Staudi14/RF_Id/Docu images/photo_2019-05-31_14-45-52.jpg

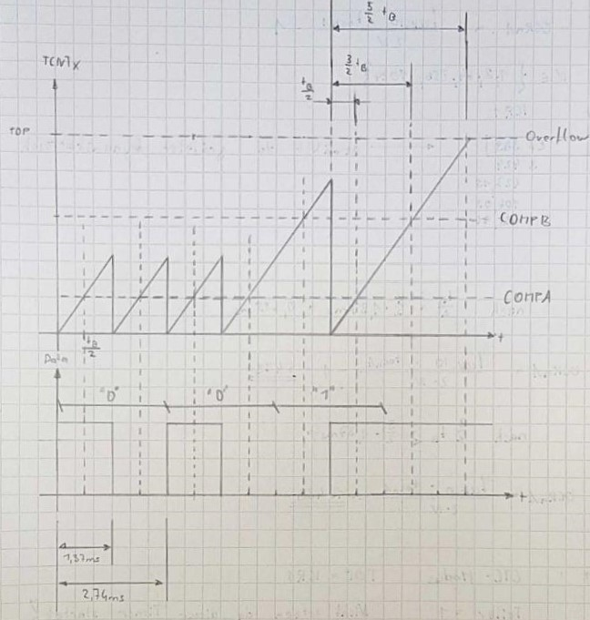
Docu images/photo_2019-05-31_14-45-52.jpg
