Staudi14/RF_Id/Dokumentation RF_ID.docx

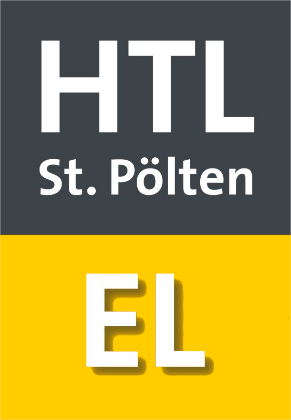
[picture p2: figure]

Dokumentation für RF-ID
Klasse | Teammitglied | Signature
4AHELS | Patrik Staudenmayer
Abgabedatum | Teammitglied | Signature
07.06.2019 | Marie Maier
Lehrer | Teammitglied | Signature
Tillich, Gruber, Crha | -
Note | Teammitglied | Signature

Projektbeschreibung

Aufbau und Programmierung eines RF-ID Tags und Lesegerät

USED DEVICES

Nummer | Gerät | Firma | Typ
1 | Labornetzteil
2 | Oszilloskope

Cover Sheet E2014 v3

Inhaltsverzeichniss

# 1 Hardware

## Lesegerät

### 1.1.1 Schaltung

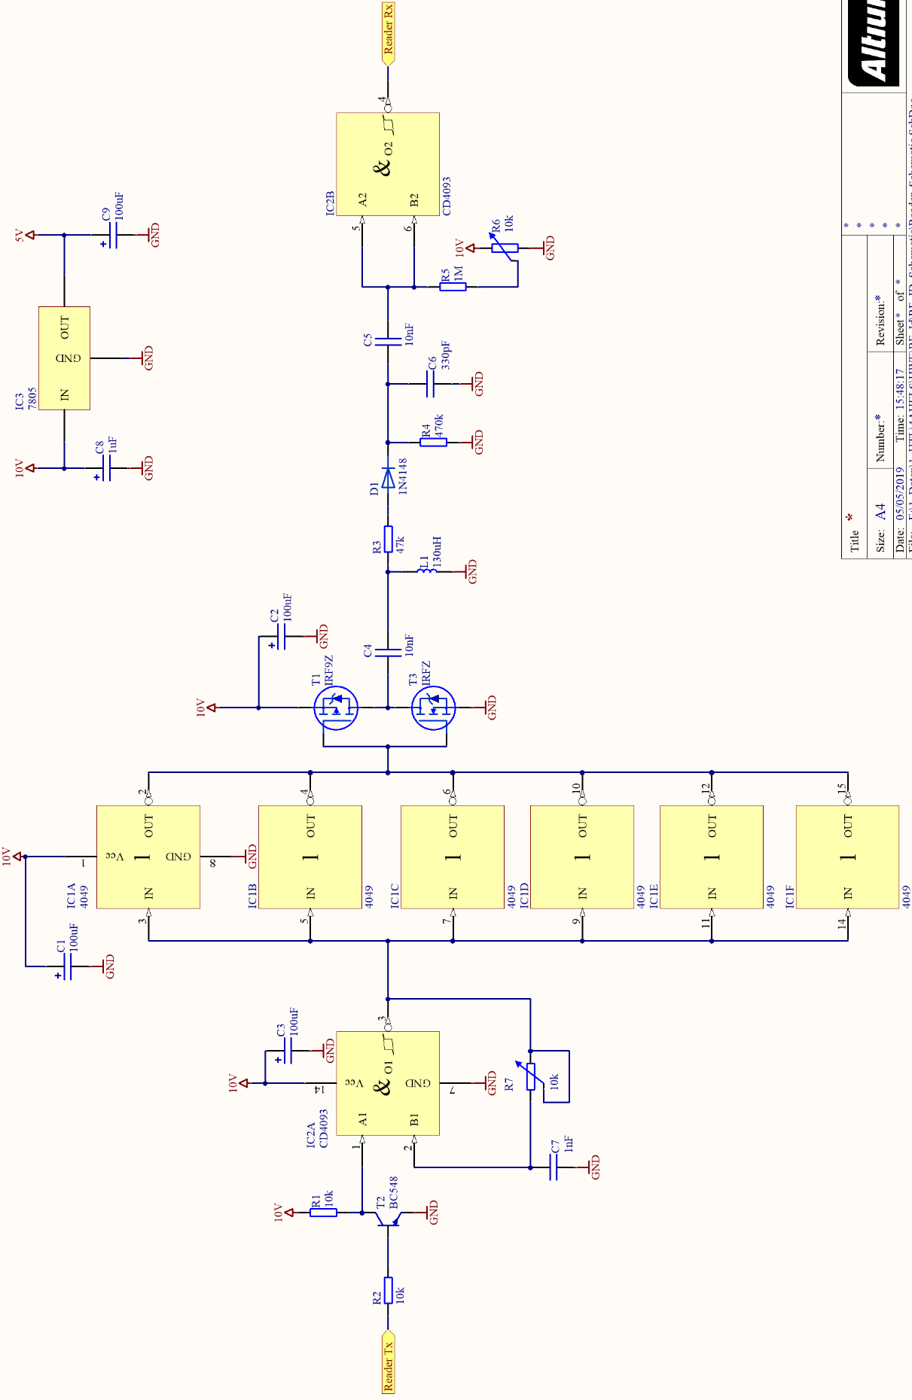
[picture p3: figure]

Endstufe

Treiber

Demodulator

Schwingkreis (≈100kHz)

RC-Oszillator ( ≈100kHz )

Abbildung 1: Schaltung Lesegerät

Abbildung 2: Schaltung Lesegerät Daten einlesen

Zum einlesen der Daten wird ein 8 Bit Schieberegister verwendet. Nachdem nur 7 Bits benötigt werden wurden nur sieben der acht Parallelen Ausgänge, des Schieberegister IC5 verwendet.

### 1.1.3 Berechnungen

#### 1.1.3.1 Resonanzfrequenz RC-Oszillator

f_0 ≈100kHz

C7=1nF

f_o ≈(2,5)/(R7*C7)

⇒R7=(2,5)/(C7* f_o)=(2,5)/(1nF*100kHz)=25kΩ

Durch Testen wurde festgestellt das ein 10k Potentiometer ausreicht, zum einstellen der gewünschten Resonanzfrequenz.

#### 1.1.3.2 Resonanzfrequenz Schwingkreis

L1=130μH

f_0 ≈100kHz

f_0 =1/(2*π*√(L1*C4))

⇒C4=((1/(f_0 *2*π))^2)/(L1)=((1/(100kHz*2*π))^2)/(130μF)=19nF

Ein 10nF Kondensator wurde verwendet, da die Oszillatorfrequenz mit dem Potentiometer abgeglichen werden kann.

## Tag

### 1.1.4 Schaltung

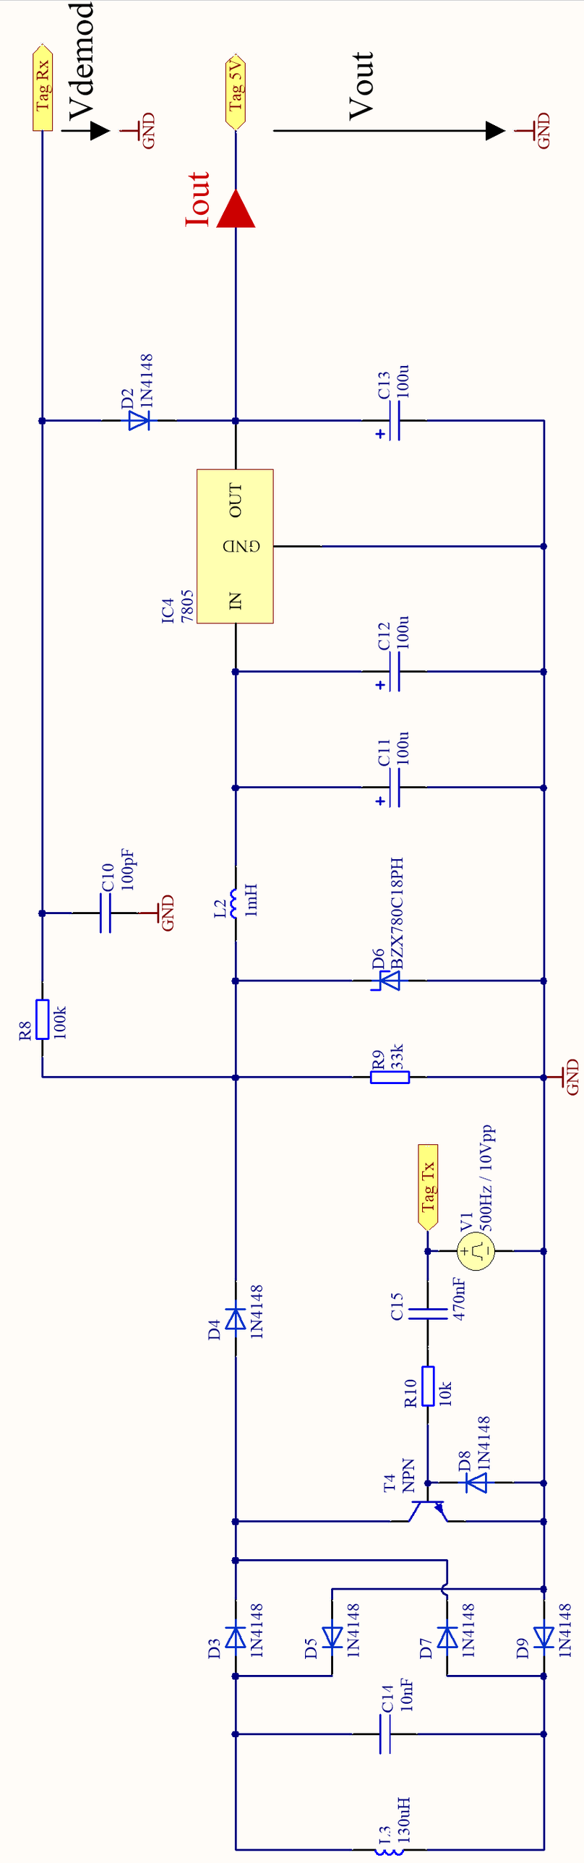
[picture p4: figure]

Längsregler 5V

Spannungsbegrenzung

Lastmodulator

Gleichrichter

Schwingkreis (≈100kHz)

Abbildung 3: Schaltung Tag

### 1.1.5 Berechnungen

#### 1.1.5.1 Schwingkreis

L3=130μH

f_0 ≈100kHz

f_0 =1/(2*π*√(L1*C4))

⇒C14=((1/(f_0 *2*π))^2)/(L1)=((1/(100kHz*2*π))^2)/(130μF)=19nF

Ein 10nF Kondensator wurde verwendet, da die Oszillatorfrequenz mit dem Potentiometer am Lesegerät abgeglichen werden kann.

### 1.1.6 Messungen

#### 1.1.6.1 Übertragungsfunktion der Spannungsversorgung des Tags

##### 1.1.6.1.1 Messschaltung

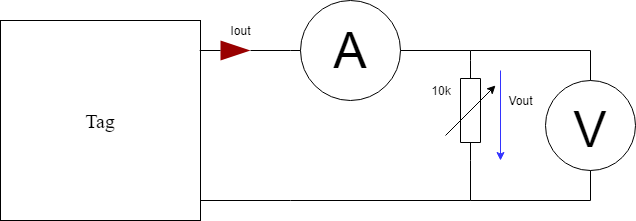
[picture p5: figure]

Abbildung 4: Messchaltung für Übertragungsfunktion Spannungsversorgung des Tags

Durch Variierung des 10kΩ Widerstands wurde die Last simuliert.

Abbildung 5: Messanordnung der Spulen

Spule Lesegerät

Plastik Abstandhalter

Spule Tag

5mm

##### 1.1.6.1.2 Messung

Vou | Iout
5.60 V | 0.04 mA
5.60 V | 6.63 mA
5.60 V | 13.74 mA
5.00 V | 18.74 mA
4.60 V | 20.67 mA
2.60 V | 23.24 mA
0.60 V | 26.11 mA

Abbildung 6: Messtabelle Übertragungsfunktion Spannungsversorgung des Tags

ssDer ATmega32u4 benötigt 14mA bei einer Taktfrequenz von 16MHz und einer Versorgungsspannung von 5V. Dies kann gerade so abgedeckt werden.

Abbildung 7: Diagramm Übertragungsfunktion Spannungsversorgung des Tags

## Übertragung zwischen Lesegerät und Tag

### 1.1.7 Übertragung von Tag zu Reader

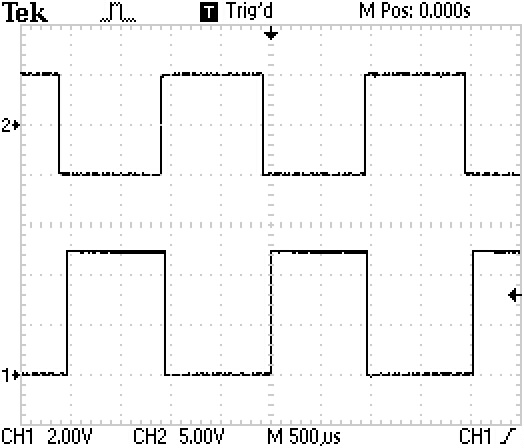
[picture p6: figure]

Tag RX

Tag TX

Abbildung 8: Oszillogramm Übertragung von Tag zu Reader

### 1.1.8 Übertragung von Reader zu Tag

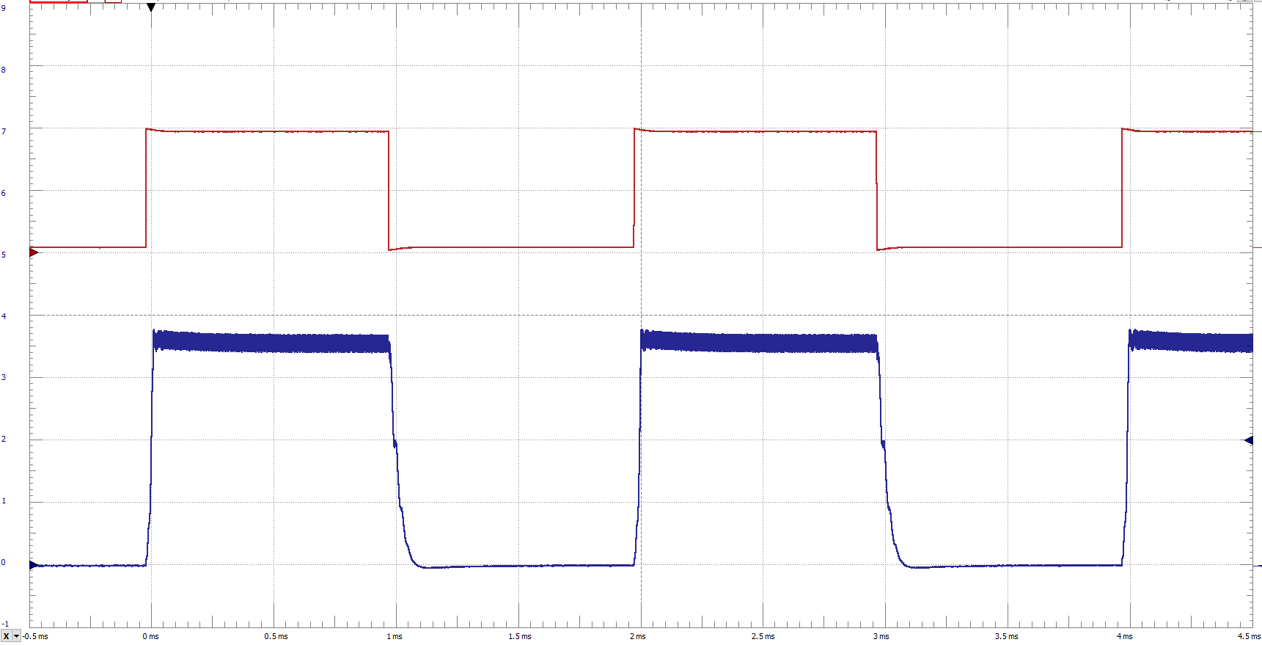
[picture p7: figure]

Tag Rx

1V/division

Reader Tx

2V/division

Abbildung 9: Oszillogramm Übertragung von Reader zu Tag

# 2 Software

Das verwendete Microcontrollerboard ist der „Flipp“ der HTBLuVA St.Pölten Abteilung für Elektronik und technische Informatik, welcher den ATmega32u4 Microcontroller beherbergt.

## Aufgabenstellung

Es soll eine Datenübertragung zwischen zwei Geräten mit folgenden Eigenschaften stattfinden:

- Zum Einlesen der Daten auf einer Seite soll ein SIPO (Seriell In, Parallel Out) Schieberegister verwendet werden.
- Die Daten sollen MSB First gespeichert werden.
- Zum Senden sollen die Daten geschoben werden.
- Die Bitdauer t_(Bit) soll 1,37ms betragen.
- Es soll das MSB zuerst gesendet werden.
- Zur Synchronisierung sollen zwei Startbits gesendet werden.
- Zur Datensicherung soll der Hamming Code verwendet werden.

Hamming (11/4) … insgesamt 11 Bit und davon 4 Paritätsbits

- Als Leitungscode soll die Manchesterkodierung verwendet werden

## Initialisierung

// RX instantiation

char GsaveD[RX_DATA_LENGTH + 1] = {0};

int8_t Gcounter = -4;

// TX instantiation

char GsendData[TX_DATA_LENGTH] = {0};

int8_t GsendCounter = 0;

char RXflag = FALSE;

void RfIDinit()

{

// Initialize Receiver Port

RX_PORT_DDR &= ~RX_PIN_MASK;

// Initial Transmitter Port

TX_PORT_DDR |= TX_PIN_MASK;

TX_PORT |= TX_PIN_MASK; // Set Tx to high to deliver energy

// Initialize Input port for shift register

DATA_INPUT_PORT_DDR = 0x00;

// Initialize Pin change interrupt

DDRD &= ~(1 << DDD3); // Initialize PD3 as Input

EICRA |= (1<<ISC31) | (1<<ISC30); // Trigger interrupt on rising and

falling edge

EIMSK |= (1<<INT3); // Locally enable Interrupt for INT3

// Initialize Timer1 for receiving

TCCR1B = TCCR1B | (1<<WGM13) | (1<<WGM12); // Set Timer1 to CTC-Mode with ICR1

as TOP

ICR1 = fICR; // Set TOP Value

OCR1A = fOCR1A; // Set threshold for COMP_A

OCR1B = fOCR1B; // Set threshold for COMP_B

TIMSK0 = TIMSK0 | (1<<OCIE0B) | (1<<OCIE0A) | (1<<ICIE1); //COMP_A, COMP_B and

Input capture as overflow

// Initialize Timer3 for sending

TCCR3B = TCCR3B | (1<<WGM33) | (1<<WGM32); // Set Timer1 to CTC-Mode with ICR3

as TOP

ICR3 = TOP_TX; // Set TOP Value

TIMSK3 |= (1 << ICIE3); // Enable Interrupt on ICIE3

}

## Manchester Kodierung

Aus zeitlichen Gründen wurde keine Manchester Kodierung programmiert.

Funktion der Manchester Kodierung:

Wenn Daten Manchester kodiert gesendet werden, werden aus einem Datenbit 2 Datenbits, aus einer 0 wird 10 und aus einer 1 wird 01. Weiters wird der Taktgehalt in der Übertragung erhöht, wodurch eine leichtere Synchronisierung von Sender und Empfänger möglich ist.

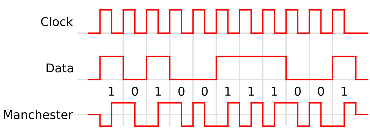
[picture p8: figure]
Bildergebnis fÃ¼r manchester codierung

Abbildung 10: Manchester Kodierung

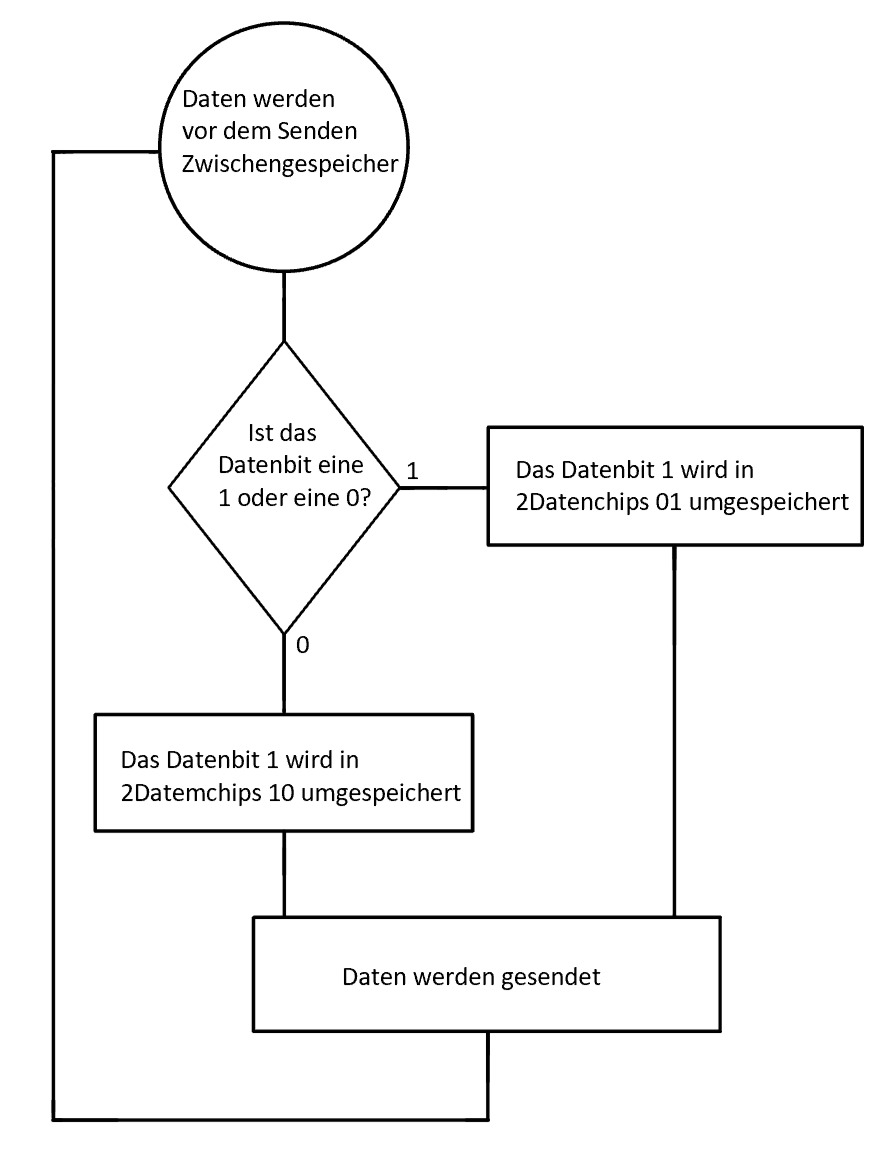
[picture p9: figure]

Abbildung 11: Flussdiagramm der Manchester Kodierung

## Hamming Code

Aus zeitlichen Gründen konnte die Hamming Codierung nicht mehr implementiert werden.

Der Hamming Code ist ein relativer Einfacher Code mit dem Hamming Abstand 3. Dies bedeutet das zwei Fehler erkannt werden können und ein Fehler korrigiert werden kann.

## Einlesen und Speichern der Daten

Aus zeitlichem Mangel konnte das Einlesen und Speichern der Daten nicht rechtzeitig fertig programmiert werden, daher wurde ein Flussdiagramm erstellt, um einen Überblick über den Ablauf der Einlese und Speicher Routine zu geben.

false

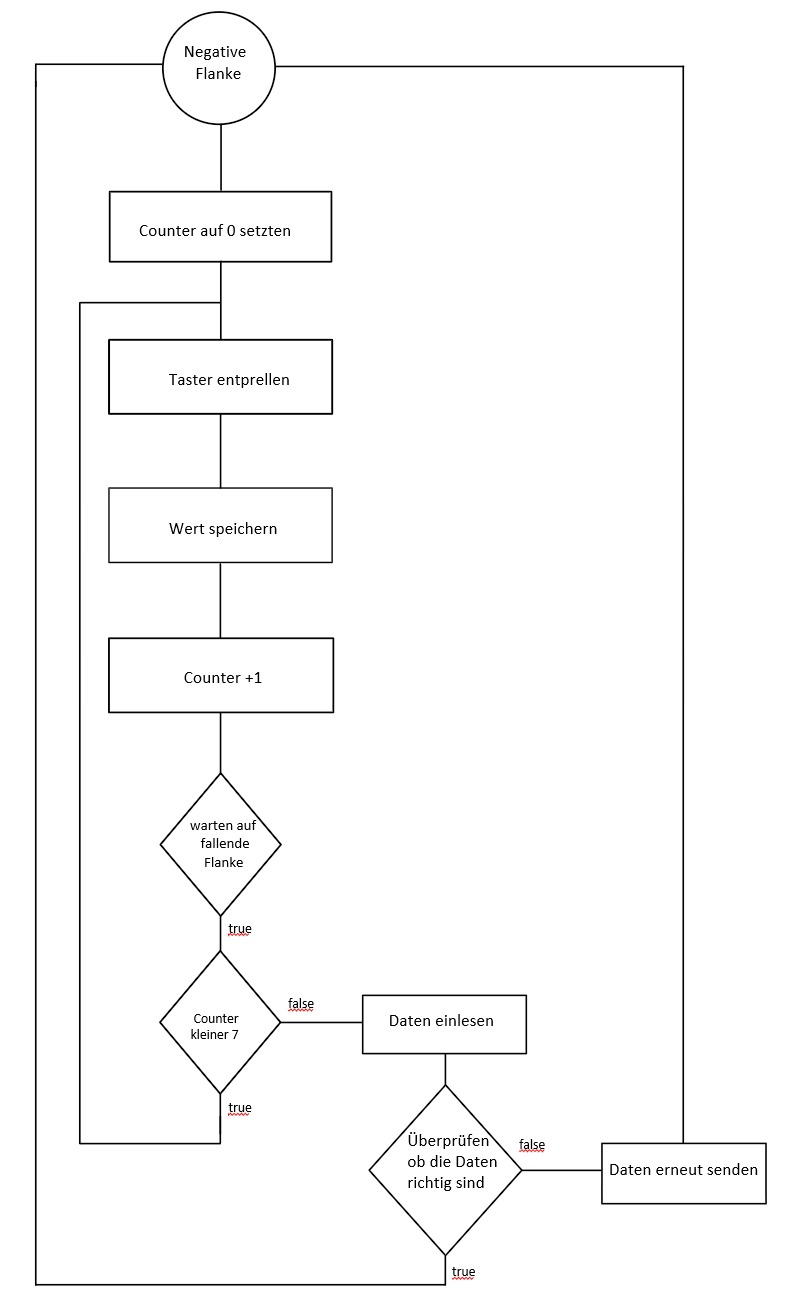
[picture p10: figure]

Abbildung 12: Flussdiagramm der Sende- und Einlese-Routine

Code 1: Interrupt Routine für Einlesen und Speichern

//Interrupt Routine

ISR(INT1_vect)

{

InputCounter++;

If(InputCounter == 7)

{

INPUT_MSB_FIRST(PORTB);

InputCounter = 0;

}

}

Code 2: Initialisierung der Einlese und Speicher Routine

// Input-Counter PD1(INT1)

#define DATA_LENGTH 7

int InputCounter = 0;

// Initialize Interrupt1 for Input-Counter

DDRD &= ~(1<<DDD1);

EIMSK = EIMSK | (1<<INT1); //locally enable Interrupt for INT1

EICRA = EICRA | (1<<ISC10) | (1<<ISC11); //set INT1 to generate an Interrupt at the

falling edge

Code 3: Speichern der Daten

#define INPUT_MSB_FIRST(input) ({ \

unsigned char ret[DATA_LENGTH]; \

char tmp = input; \

do { \

for (int i = 0; i < DATA_LENGTH; i++) \

{ \

ret[DATA_LENGTH - 1 - i] = (((1 << i) & tmp) == (1 << i) ? 1: 0);\

} \

} while(0); \

ret; \

})

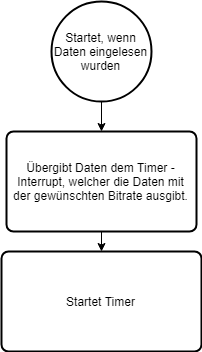
[picture p11: figure]

## Senderoutine

### 2.1.1 Senderoutine Starten

Um die Senderoutine zu starten wird das Makro RF_ID_SEND (Code 1) verwendet. Diese führt die in der Abbildung 14: Flussdiagram des Sende Makros dargestellten Tätigkeiten durch. Hierbei ist zur Implementierung anzumerken, dass, wenn die Übergabe der Daten mittels Globaler Variablen implementiert wird, welche sowohl im Main als auch in der Library verwendbar sein sollen, so muss das C Schlüsselwort extern verwendet werden.

Variablen, die mit dem Schlüsselwort extern deklariert werden, werden bei der Deklaration noch kein Speicher zugewiesen, dies geschieht erst bei der Definition welche bei der hier gewählten Implementation in dem „RF_ID.c“ File stattfindet.

Um die Synchronität zu gewährleisten wird am Anfang einer jeden Transaktion die Bits „11“ Manchester kodiert gesendet.

Abbildung 13: Flussdiagram des Sende Makros

Code 4: Makro zum Starten der Senderoutine

/*

*@function RfIDsend

*@abstract Handles the transmission of the given data

*@discussion Calculates the Hamming code of the given and encodes it to Manchester code then handles the correct set up of the timer

* and assigns the encoded data to GsendData.

*@param data Is the pointer to the transmitted data

*/

#define RF_ID_SEND(data) ({ \

for(int i = 0; i < TX_DATA_LENGTH; i++) \

{ \

GsendData[i] = data[i]; \

} \

GsendCounter = 0; \

\

TCCR3B |= (1 << CS30); /* Start Timer3 (Set divider to 1) */ \

})

### 2.1.2 Timer der Senderoutine

Um eine fixe Bitrate zu gewährleisten wurde der Timer 3 des ATmega32u4 im CTC Modus verwendet. Ein Bit wird gesendet, wenn dieser Timer den Topwert erreicht hat, welcher mittels des ICR3 Registers festgelegt wurde und welcher beim Erreichen den Timer 3 Capture Interrupt auslöst, wenn dieser freigeschalten ist.

#### 2.1.2.1 Berechnung der Timer Parameter

Anforderung: Es soll alle 1,37ms ein Bit gesendet werden.

f_(OCnA) =(f_(CLK_I/O))/(2*N*(1+OCRnA))

⇒1/(t_(Bit))=(f_(CLK_I/O))/(2*N*(1+OCRnA))

⇒OCRnA= (f_(CLK_I/O) *t_(Bit))/(2*N)-1

N∈{1;8;64;256;1024}

Der Microcontroller wird mit einer f_(CLK_I/O) von 16MHz betrieben.

Mithilfe von Excel wurde folgende Tabelle erstellt:

gewählt

Teiler N | ICR3
1 | 10959.00
8 | 1369.00
64 | 170.25
256 | 41.81
1024 | 9.70

Abbildung 14: Mögliche Werte für den Timer der Senderoutine

Die Kriterien, die hier erfüllt werden mussten, war:

- < 2^16 , da Timer 3 ein 16 Bit Timer ist.
- >200 , um falls nötig die Grenze noch verstellen zu können.

#### 2.1.2.2 Interruptroutine des Timer 3 Capture Interrupt

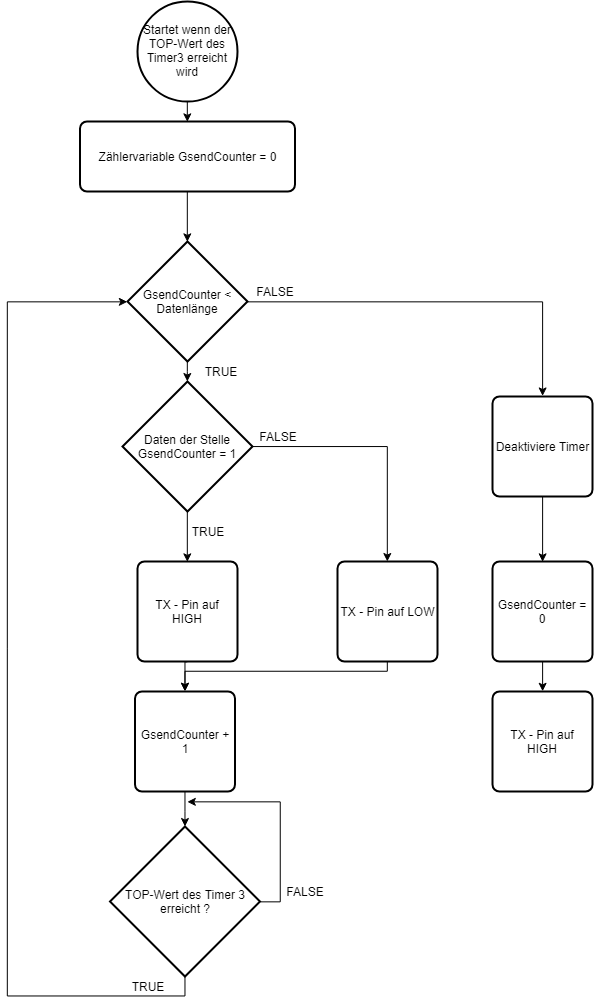
[picture p12: figure]

In Abbildung 16: Flussdiagram Interrupt Routine Timer 3 Capture Interrupt ist dargestellt wie das senden in der Interrupt Routine bewerkstelligt wird.

Abbildung 15: Flussdiagram Interrupt Routine Timer 3 Capture Interrupt

Code 5: Sende Interrupt Routine des Timer 3 Capture Interrupt

ISR(TIMER3_CAPT_vect)

{

// Send Interrupt

if (GsendCounter < TX_DATA_LENGTH)

{

if(GsendData[GsendCounter] == 1)

{

TX_PORT |= TX_PIN_MASK;

}

else

{

TX_PORT &= ~TX_PIN_MASK;

}

GsendCounter++;

}

else

{

GsendCounter = 0;

TCCR3B &= ~(1 << CS32) & ~(1 << CS31) & ~(1 << CS30);

// Deactivate Timer3

TCNT3 = 0; // Reset Timer3

TX_PORT |= TX_PIN_MASK;

}

}

## Empfangsroutine

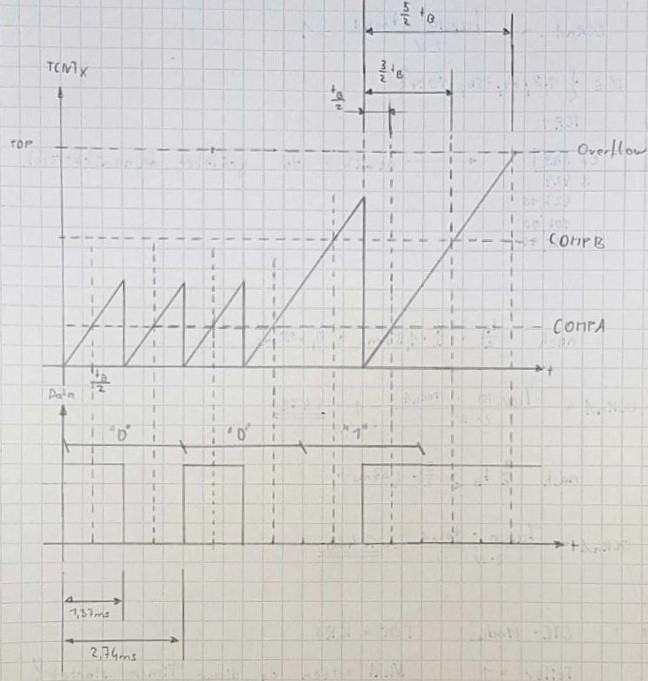
[picture p13: figure]

Abbildung 16: Timing Diagramm der Empfangsroutine

Zum Empfangen, der gesendeten Daten, wird der 16-Bit Timer 1 im CTC-Modus verwendet. Der COMPA Interrupt wird verwendet, um das erste Bit des Symbols zu empfangen, der COMPB Interrupt wird verwendet, um das erste Bit des darauffolgenden Symbols zu empfangen, falls die beiden verschiedene Symbole, des Manchester Codes, hintereinander gesendet wurden. Der Overflow Interrupt dient zum Erkennen des Endes der Datenübertragung.

Der Pin-Change Interrupt INT3 – PD3 des ATmega32u4 – wird verwendet, um den Sender und Empfänger Synchron zu halten. Im Interrupt wird bei einer Flanke das Counter Register des Timer 1 auf 0 gesetzt und dadurch ist die Synchronität des Sender und Empfängers gewährleistet.

### 2.1.3 Timer der Empfangsroutine

#### 2.1.3.1 Berechnung der Timer Parameter

Anforderung:

- COMPA soll nach 685ns erreicht werden.
- COMPB soll nach 2,055ms erreicht werden.
- TOP soll nach 3,425ms erreicht werden.

f_(OCnA) =(f_(CLK_I/O))/(2*N*(1+OCRnA))

⇒1/(t_(Bit))=(f_(CLK_I/O))/(2*N*(1+OCRnA))

⇒OCRnA= (f_(CLK_I/O) *t_(Bit))/(2*N)-1

N∈{1;8;64;256;1024}

Der Microcontroller wird mit einer f_(CLK_I/O) von 16MHz betrieben.

Mithilfe von Excel wurden folgende Tabellen erstellt:

gewählt

Divider N | OCRnA (Register zum Festlegen der Grenzte für den COMPA Interrupt)
1 | 5479.00
8 | 684.00
64 | 84.63
256 | 20.41
1024 | 4.35

Abbildung 17: Mögliche Werte für den Wert des OCRnA Registers

gewählt

Divider N | OCRnB (Register zum Festlegen der Grenze für den COMPB Interrupt)
1 | 16439.00
8 | 2054.00
64 | 255.88
256 | 63.22
1024 | 15.05

Abbildung 18: Mögliche Werte für den Wert des OCRnB Registers

gewählt

Divider N | ICRn (Register zum Festlegen der Grenze für den Input Capture Interrupt)
1 | 27399.00
8 | 3424.00
64 | 427.13
256 | 106.03
1024 | 25.76

Abbildung 19: Mögliche Werte für den Wert des ICRn Registers

### 2.1.4 Flussdiagram der Empfangsroutine

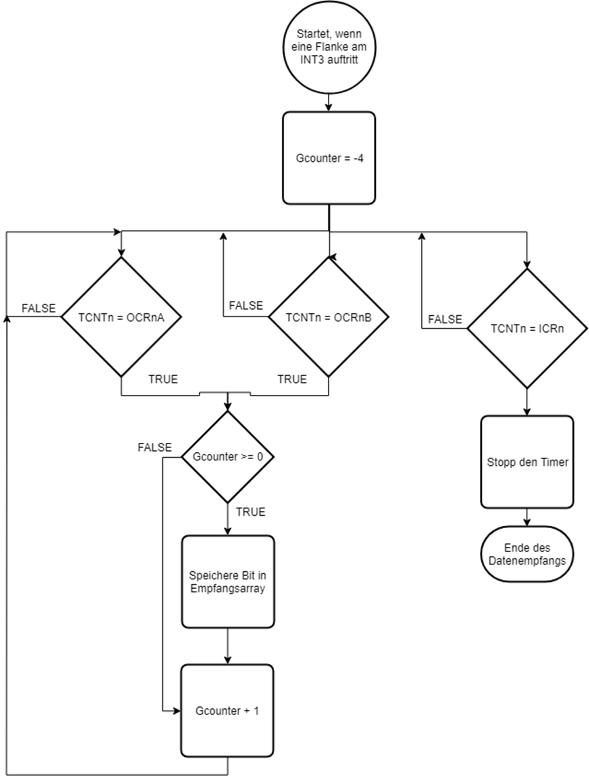
[picture p14: figure]

Abbildung 20: Flussdiagram der Empfangsroutine

### 2.1.5 Code der Empfangsroutine

Code 6: Implementierung der Empfangsroutine

ISR(TIMER1_COMPA_vect)

{

// First routine to be triggered when something received

if (Gcounter >= 0)

{

GsaveD[Gcounter] = RX_PORT & RX_PIN_MASK;

}

Gcounter++;

}

ISR(TIMER1_COMPB_vect)

{

// Second routine to be triggered when something received

if (Gcounter >= 0)

{

GsaveD[Gcounter] = RX_PORT & RX_PIN_MASK;

}

Gcounter++;

}

ISR(TIMER1_CAPT_vect)

{

// Ends the transaction

Gcounter = -4;

RXflag = TRUE;

TCCR1B = TCCR1B & ~(1<<CS10) & ~(1<<CS11) & ~(1<<CS12); //Timer1 stopped

}

Projekt: RF-ID Rev. 1 Page 1 | 1

Patrik Staudenmayer, Marie Maier4AHELS
