Staudi14/RF_Id/(list of files, drawings)

Other design files:
RF_ID_Schematic/Input_Schematic.SchDoc
RF_ID_Schematic/Reader_Schematic.SchDoc
RF_ID_Schematic/RF_ID_Schematic.PrjPcb
RF_ID_Schematic/Tag_Schematic.SchDoc
