Staudi14/RF_Id/Measurements/transfer charasteristic output voltage with regulator and Z Diode.xlsx

 |  |  | Changed adjusting potentiometer to 10k. Added Z Diode (BZX 780C 18 PH)
Vout [V] | Iout [mA]
5.60 V | 0.04 mA
5.60 V | 6.63 mA
5.60 V | 13.74 mA
5.00 V | 18.74 mA
4.60 V | 20.67 mA
2.60 V | 23.24 mA
0.60 V | 26.11 mA
Vout [V] | Iout [mA] | without load modulation
5.28 V | 0.04 mA
5.28 V | 0.43 mA
5.28 V | 12.23 mA
5.28 V | 25.75 mA
5.28 V | 44.00 mA
5.28 V | 48.50 mA
5.20 V | 54.00 mA
3.84 V | 67.90 mA
3.52 V | 71.00 mA
0.40 V | 75.60 mA
