Staudi14/RF_Id/Measurements/transfer charasteristic output voltage with regulator.xlsx

Sheet: new caps
Vout [V] | Iout [mA]
5.11 | 0.04
5.11 | 0.36
5.11 | 1.07
5.11 | 2.13
4.75 | 3.62 | do again the whole thing!!!
4.5 | 4.04
3.12 | 6.78
0.03 | 10.32

Sheet: old caps
Vout [V] | Iout [mA]
5.11 | 0.04
5.11 | 0.09
5.11 | 0.1
5.109 | 0.13
5.102 | 0.18
5.1 | 0.22
5.082 | 0.3
5.04 | 0.42
4.98 | 0.56
4.86 | 0.81
4.28 | 2.11
3.036 | 5.02
0.03 | 9
