Staudi14/RF_Id/Measurements/transfer charasteristic output voltage without regulator.ods

Vout [V] | Iout [mA]
3,7 | 16
3,6 | 16
3,5 | 16
3,4 | 17
3,3 | 17
3 | 16
2,8 | 16
2,5 | 16
1,6 | 18
1,25 | 19
0,9 | 22
0,7 | 24
0,022 | 32
0,018 | 32
