Staudi14/RF_Id/Measurements/RX Tag.csv

Time (s) | Rx (V) | Tx (V)
-0.000580726 | -0.0151773 | 0.168113
-0.000580096 | -0.0118809 | 0.171756
-0.000579466 | -0.00858446 | 0.168113
-0.000578836 | -0.0151773 | 0.171756
-0.000578206 | -0.0118809 | 0.171756
-0.000577576 | -0.00858446 | 0.171756
-0.000576946 | -0.0118809 | 0.171756
-0.000576316 | -0.0151773 | 0.168113
-0.000575686 | -0.0118809 | 0.164469
-0.000575056 | -0.0151773 | 0.179043
-0.000574426 | -0.0151773 | 0.175399
-0.000573796 | -0.0151773 | 0.171756
-0.000573166 | -0.0151773 | 0.171756
-0.000572536 | -0.0151773 | 0.171756
-0.000571906 | -0.0118809 | 0.168113
-0.000571276 | -0.00858446 | 0.160826
-0.000570646 | -0.0151773 | 0.171756
-0.000570016 | -0.0151773 | 0.171756
-0.000569386 | -0.0151773 | 0.171756
-0.000568756 | -0.0118809 | 0.171756
-0.000568126 | -0.0151773 | 0.164469
-0.000567496 | -0.0151773 | 0.171756
-0.000566866 | -0.0118809 | 0.168113
-0.000566236 | -0.0151773 | 0.171756
-0.000565606 | -0.0217701 | 0.168113
-0.000564976 | -0.0151773 | 0.168113
-0.000564346 | -0.0118809 | 0.171756
-0.000563716 | -0.0118809 | 0.171756
-0.000563086 | -0.00858446 | 0.168113
-0.000562456 | -0.0151773 | 0.168113
-0.000561826 | -0.0151773 | 0.164469
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
