Staudi14/RF_Id/Measurements/RX Reader.JPG

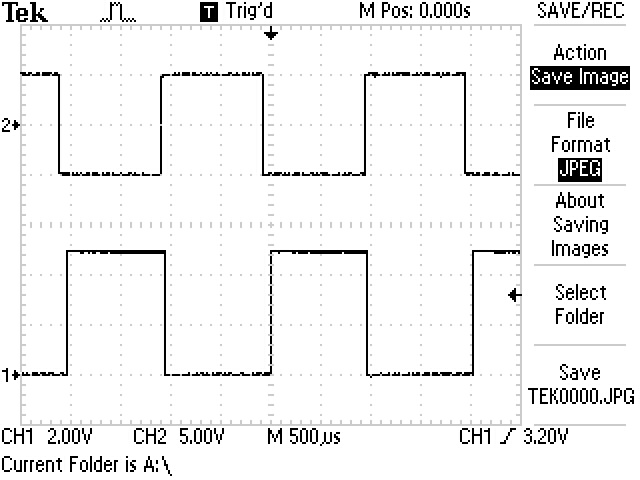
Measurements/RX Reader.JPG
