Staudi14/RF_Id/Measurements/RX Tag.png

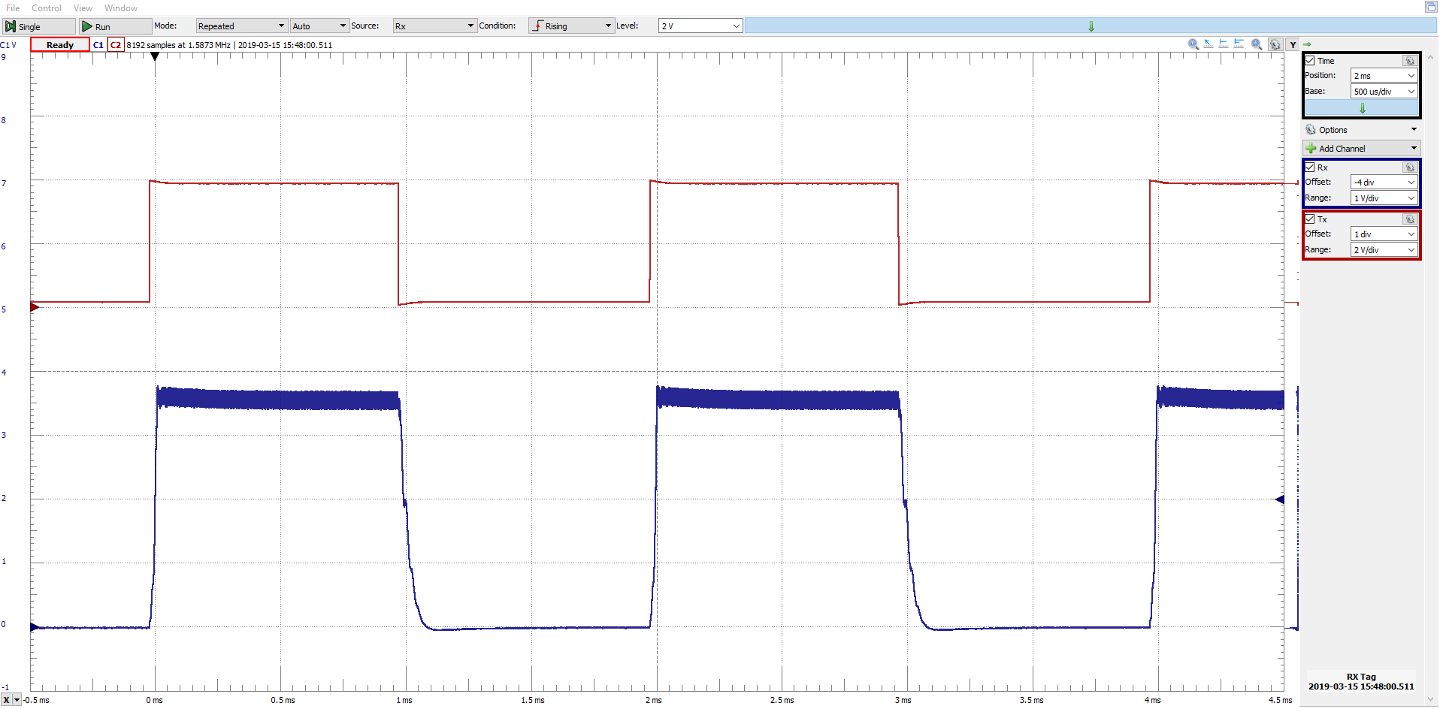
Measurements/RX Tag.png
