Staudi14/RF_Id/(commit log)

2019-03-15 transfer characteristics output voltage
    [transfer charasteristic output voltage.ods]
2019-03-15 anfänglicher commit der software
2019-03-15 Added RX measurements
    [RX Tag.csv]
2019-03-23 Added some measurements
    [RX Tag.csv, transfer charasteristic output voltage with regulator.xlsx, transfer charasteristic output voltage without regulator.ods]
2019-03-29 Added measurement of updated circuit
    Vcc to 10V
    Added Z-Diode on reader to limit voltage before linear regulator to 18V
    [transfer charasteristic output voltage with regulator and Z Diode.xlsx]
2019-05-04 Drew Reader Schematic
    [RF_ID_Schematic.PrjPcb, Reader_Schematic.SchDoc]
2019-05-06 +Updated documentation
    [RF_ID_Schematic.PrjPcb, Reader_Schematic.SchDoc, Tag_Schematic.SchDoc, transfer charasteristic output voltage with regulator and Z Diode.xlsx]
2019-05-10 Started init function
    [Calc Timer.xlsx]
2019-05-17 +Update Added more comments
    [Calc Timer.xlsx]
2019-05-17 +Update Debugging Timer3
2019-05-17 +Update Sending Interrupt works :crystal_ball:
2019-05-24 +Update Resolved merge conflicts
    [RF_ID.h]
2019-05-24 +Update worked on wrong branch
    [RF_ID.c, RF_ID.h, main.c]
2019-05-31 +Update Dokumentation
    [Input_Schematic.SchDoc, RF_ID_Schematic.PrjPcb]
2019-06-05 +Update Schematic
